azure-dynamics/navigator/fabrication/navigator.csv

Reference | Value | DigiKey_PN | Footprint | Qty
C1 | 100uF | PCE3809CT-ND | Capacitor_SMD:CP_Elec_8x10.5 | 1
C2 | 10uF | 1276-3387-1-ND | Capacitor_SMD:C_1210_3225Metric | 1
C3,C6 | 10uF | 1276-2872-1-ND | Capacitor_SMD:C_0805_2012Metric | 2
C4,C12 | 1uF | 490-1695-1-ND | Capacitor_SMD:C_0805_2012Metric | 2
C5 | 47uF | GRM32ER61C476ME15L | Capacitor_SMD:C_1210_3225Metric | 1
C7,C8,C9,C10,C11,C13 | 0.1uF | 1276-1003-1-ND | Capacitor_SMD:C_0805_2012Metric | 6
D1,D2 | D_Schottky | MBR0560TPMSCT-ND | Diode_SMD:D_SOD-123 | 2
J1,J2,J3,J4,J5,J6 | BLDC-1 | 2057-PH1RB-03-UA-ND | Connector_PinHeader_2.54mm:PinHeader_1x03_P2.54mm_Horizontal | 6
J7 | Conn_01x02_Pin | 455-S2P-VH-ND | Connector_JST:JST_VH_S2P-VH_1x02_P3.96mm_Horizontal | 1
J8 | USB_C_Receptacle_USB2.0_16P | 664-12401948E412ACT-ND | Connector_USB:USB_C_Receptacle_Amphenol_12401948E412A | 1
J9 | Conn_01x04_Pin | 455-1566-1-ND | Connector_JST:JST_GH_BM04B-GHS-TBT_1x04-1MP_P1.25mm_Vertical | 1
J10 | GPIO | 1528-2831-ND | Connector_PinSocket_2.54mm:PinSocket_2x20_P2.54mm_Vertical | 1
R1,R2,R3,R4,R5,R6,R9,R14,R15,R16,R17 | 10k | RMCF0805JT10K0CT-ND | Resistor_SMD:R_0805_2012Metric | 11
R7 | 100k | 311-100KARCT-ND | Resistor_SMD:R_0805_2012Metric | 1
R8 | 14k3 | 118-CR0805-FX-1432ELFCT-ND | Resistor_SMD:R_0805_2012Metric | 1
R10,R11 | 5k1 | RMCF0805JT5K10CT-ND | Resistor_SMD:R_0805_2012Metric | 2
R12,R13 | 2k2 | A106060CT-ND | Resistor_SMD:R_0805_2012Metric | 2
SW1,SW2 | SW_SPST | EG5350CT-ND | Button_Switch_SMD:SW_SPST_TL3305A | 2
U1 | AP2112K-3.3 | AP2112K-3.3TRG1DICT-ND | Package_TO_SOT_SMD:SOT-23-5 | 1
U2 | MPM3550EGLE | 1589-2043-ND | Package_LGA:MPS_LGA-18-10EP_12x12mm_P3.3mm | 1
U3 | BNO086 | 1888-BNO086CT-ND | BNO086:BNO086 | 1
U4 | ESP32-S3-MINI-1U | 1965-ESP32-S3-MINI-1U-N8CT-ND | PCM_Espressif:ESP32-S3-MINI-1U | 1
U5 | INA226 | 296-29034-1-ND | Package_SO:TSSOP-10_3x3mm_P0.5mm | 1
