azure-dynamics/navigator/hardware/navigator.kicad_pcb

## KiCad design hardware/navigator.kicad_pcb (2026-11-02)

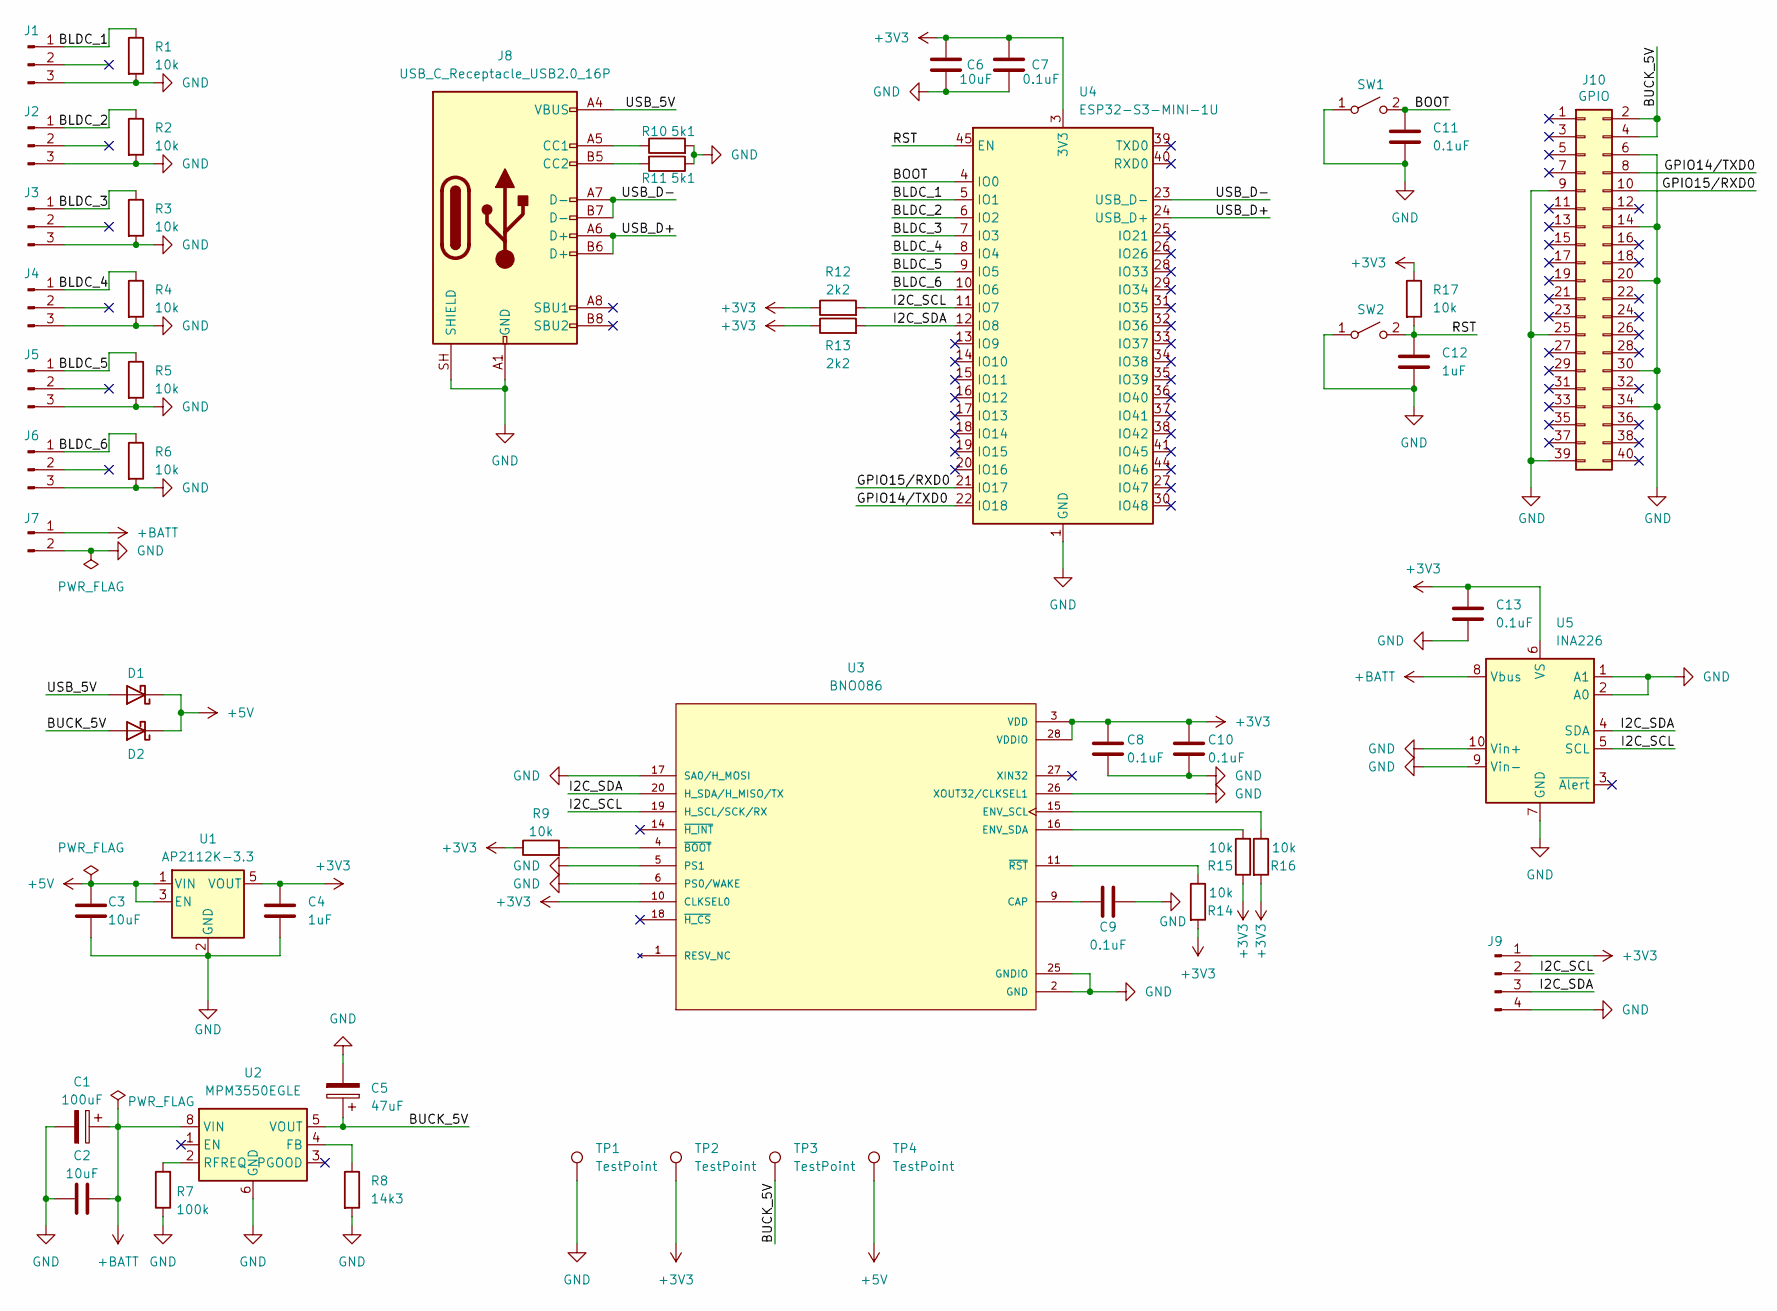
[picture p1: schematic navigator.kicad_sch]

Parts:
C1: 100uF; CP_Elec_8x10.5; DigiKey_PN PCE3809CT-ND
C2: 10uF; C_1210_3225Metric; DigiKey_PN 1276-3387-1-ND
C3, C6: 10uF; C_0805_2012Metric; DigiKey_PN 1276-2872-1-ND
C4, C12: 1uF; C_0805_2012Metric; DigiKey_PN 490-1695-1-ND
C5: 47uF; C_1210_3225Metric; DigiKey_PN GRM32ER61C476ME15L
C7, C8, C9, C10, C11, C13: 0.1uF; C_0805_2012Metric; DigiKey_PN 1276-1003-1-ND
D1, D2: D_Schottky; D_SOD-123; DigiKey_PN MBR0560TPMSCT-ND
J1, J2, J3, J4, J5, J6: BLDC-1; PinHeader_1x03_P2.54mm_Horizontal; DigiKey_PN 2057-PH1RB-03-UA-ND
J7: Conn_01x02_Pin; 282837-2; DigiKey_PN A113320-ND
J8: USB_C_Receptacle_USB2.0_16P; USB_C_Receptacle_Amphenol_12401948E412A; DigiKey_PN 664-12401948E412ACT-ND
J9: Conn_01x04_Pin; JST_GH_BM04B-GHS-TBT_1x04-1MP_P1.25mm_Vertical; DigiKey_PN 455-1566-1-ND
J10: GPIO; PinSocket_2x20_P2.54mm_Vertical; DigiKey_PN 1528-2831-ND
R1, R2, R3, R4, R5, R6, R9, R14, R15, R16, R17: 10k; R_0805_2012Metric; DigiKey_PN RMCF0805JT10K0CT-ND
R7: 100k; R_0805_2012Metric; DigiKey_PN 311-100KARCT-ND
R8: 14k3; R_0805_2012Metric; DigiKey_PN 118-CR0805-FX-1432ELFCT-ND
R10, R11: 5k1; R_0805_2012Metric; DigiKey_PN RMCF0805JT5K10CT-ND
R12, R13: 2k2; R_0805_2012Metric; DigiKey_PN A106060CT-ND
SW1, SW2: SW_SPST; SW_SPST_TL3305A; DigiKey_PN EG5350CT-ND
TP1, TP2, TP3, TP4: TestPoint; TestPoint_Pad_1.5x1.5mm
U1: AP2112K-3.3; SOT-23-5; DigiKey_PN AP2112K-3.3TRG1DICT-ND
U2: MPM3550EGLE; MPS_LGA-18-10EP_12x12mm_P3.3mm; DigiKey_PN 1589-2043-ND
U3: BNO086; PARTREV v1.17; DigiKey_PN 1888-BNO086CT-ND
U4: ESP32-S3-MINI-1U; DigiKey_PN 1965-ESP32-S3-MINI-1U-N8CT-ND
U5: INA226; TSSOP-10_3x3mm_P0.5mm; DigiKey_PN 296-29034-1-ND

Connections:
+3V3: C4.1, C6.1, C7.1, C8.1, C10.1, C13.1, J9.1, R9.1, R12.1, R13.1, R14.2, R15.1, R16.2, R17.1, TP2.1, U1.5 (VOUT), U3.3 (VDD), U3.10 (CLKSEL0), U3.28 (VDDIO), U4.3 (3V3), U5.6 (VS); also elsewhere on the board
+5V: C3.1, D1.1 (K), D2.1 (K), TP4.1, U1.1 (VIN), U1.3 (EN); also elsewhere on the board
+BATT: C1.1, C2.2, J7.1, U2.8 (VIN), U5.8 (Vbus)
/BLDC_1: J1.1, R1.1, U4.5 (IO1)
/BLDC_2: J2.1, R2.1, U4.6 (IO2)
/BLDC_3: J3.1, R3.1, U4.7 (IO3)
/BLDC_4: J4.1, R4.1, U4.8 (IO4)
/BLDC_5: J5.1, R5.1, U4.9 (IO5)
/BLDC_6: J6.1, R6.1, U4.10 (IO6)
/BOOT: C11.1, SW1.2 (B), U4.4 (IO0)
/BUCK_5V: C5.1, D2.2 (A), J10.2, J10.4, TP3.1, U2.5 (VOUT); also elsewhere on the board
/GPIO14/TXD0: J10.8, U4.22 (IO18)
/GPIO15/RXD0: J10.10, U4.21 (IO17)
/I2C_SCL: J9.2, R12.2, U3.19 (H_SCL/SCK/RX), U4.11 (IO7), U5.5 (SCL)
/I2C_SDA: J9.3, R13.2, U3.20 (H_SDA/H_MISO/TX), U4.12 (IO8), U5.4 (SDA)
/RST: C12.1, R17.2, SW2.2 (B), U4.45 (EN)
/USB_5V: D1.2 (A), J8.A4 (VBUS), J8.A9 (VBUS), J8.B4 (VBUS), J8.B9 (VBUS)
/USB_D+: J8.A6 (D+), J8.B6 (D+), U4.24 (USB_D+)
/USB_D-: J8.A7 (D-), J8.B7 (D-), U4.23 (USB_D-)
GND: C1.2, C2.1, C3.2, C4.2, C5.2, C6.2, C7.2, C8.2, C9.2, C10.2, C11.2, C12.2, C13.2, J1.3, J2.3, J3.3, J4.3, J5.3, J6.3, J7.2, J8.A1 (GND), J8.A12 (GND), J8.B1 (GND), J8.B12 (GND), J8.SH (SHIELD), J9.4, J10.6, J10.9, J10.14, J10.20, J10.25, J10.30, J10.34, J10.39, R1.2, R2.2, R3.2, R4.2, R5.2, R6.2, R7.1, R8.2, R10.2, R11.1, SW1.1 (A), SW2.1 (A), TP1.1, U1.2 (GND), U2.6 (GND), U2.7 (GND), U2.9 (GND), U2.10 (GND), U2.11 (GND), U2.12 (GND), U2.13 (GND), U2.14 (GND), U2.15 (GND), U2.16 (GND), U2.17 (GND), U2.18 (GND), U3.2 (GND), U3.5 (PS1), U3.6 (PS0/WAKE), U3.17 (SA0/H_MOSI), U3.25 (GNDIO), U3.26 (XOUT32/CLKSEL1), U4.1 (GND), U4.2 (GND), U4.42 (GND), U4.43 (GND), U4.46 (GND), U4.47 (GND), U4.48 (GND), U4.49 (GND), U4.50 (GND), U4.51 (GND), U4.52 (GND), U4.53 (GND), U4.54 (GND), U4.55 (GND), U4.56 (GND), U4.57 (GND), U4.58 (GND), U4.59 (GND), U4.60 (GND), U4.61 (GND), U4.62 (GND), U4.63 (GND), U4.64 (GND), U4.65 (GND), U5.1 (A1), U5.2 (A0), U5.7 (GND), U5.9 (Vin-), U5.10 (Vin+); also elsewhere on the board
unnamed: J8.A5 (CC1), R10.1
unnamed: J8.B5 (CC2), R11.2
unnamed: R8.1, U2.4 (FB)
unnamed: R7.2, U2.2 (RFREQ)
unnamed: C9.1, U3.9 (CAP)
unnamed: R16.1, U3.15 (ENV_SCL)
unnamed: R15.2, U3.16 (ENV_SDA)
unnamed: R9.2, U3.4 (~BOOT)
unnamed: R14.1, U3.11 (~RST)

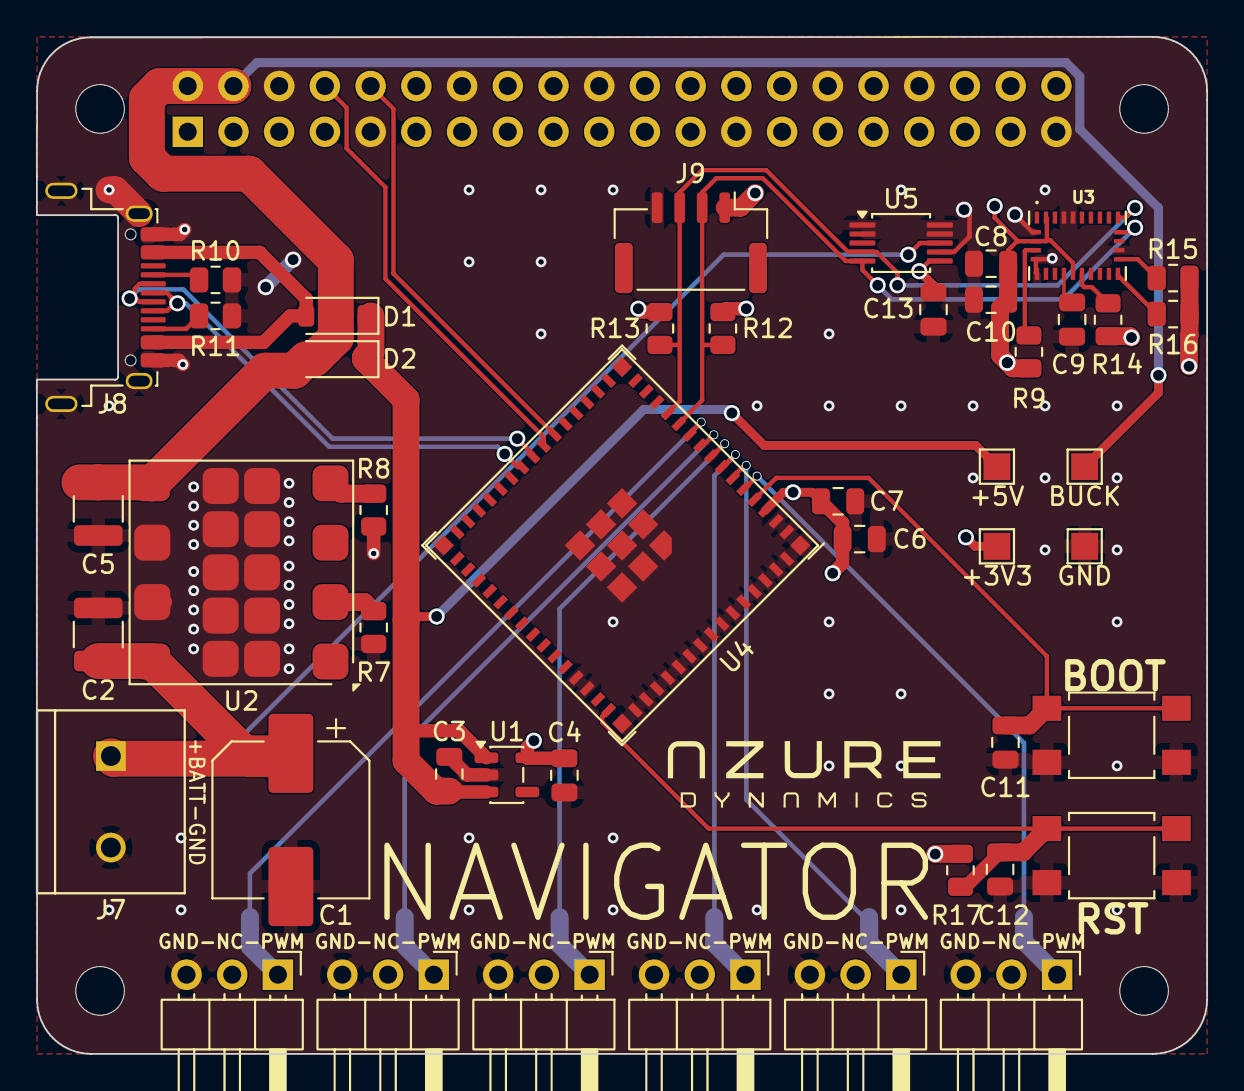
[picture p2: board navigator.kicad_pcb from above]

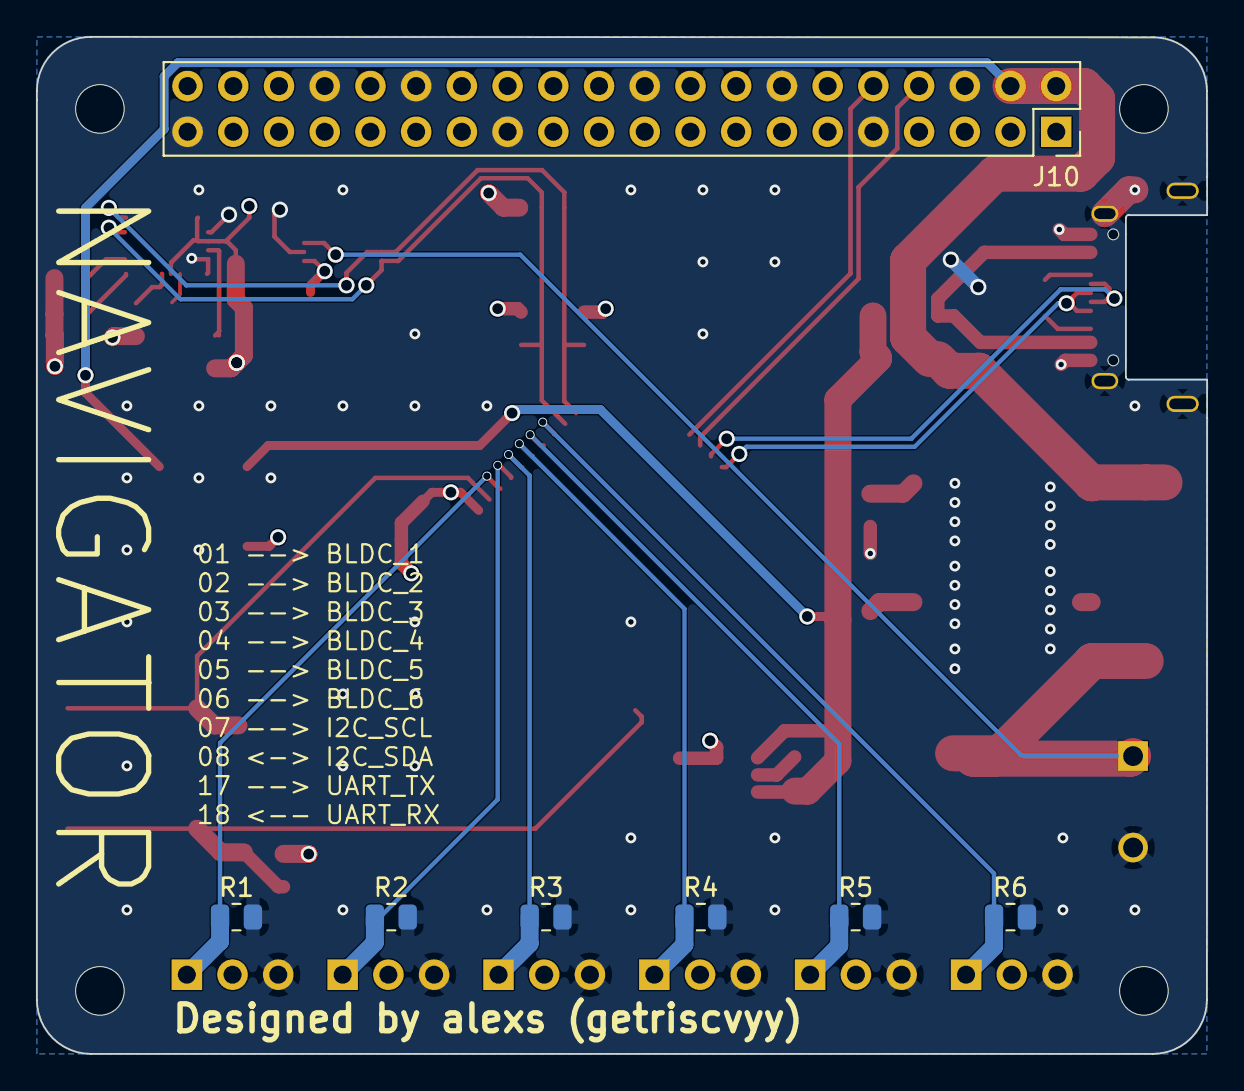
[picture p3: board navigator.kicad_pcb from below]

Board: 4 copper layers, 65.0 x 56.5 mm, 57 parts (7 on the bottom side), 29 nets.

Other parts of the board:
+3V3, +5V: TestPoint; TestPoint_Pad_1.5x1.5mm
BUCK: TestPoint; TestPoint_Pad_1.5x1.5mm
GND: TestPoint; TestPoint_Pad_1.5x1.5mm
MH1, MH2, MH3, MH4: MountingHole_2.7mm_M2.5

Their connections:
+3V3: +3V3.1 (1_1); also elsewhere on the board
+5V: +5V.1 (1_1); also elsewhere on the board
/BUCK_5V: BUCK.1 (1_1); also elsewhere on the board
GND: GND.1 (1_1); also elsewhere on the board
