azure-dynamics/navigator/(commit log)

2026-10-31 chore: add gitignore for kicad local files
2026-10-31 feat: update navigator hardware to revision 002
    [navigator.kicad_pcb, navigator.kicad_sch]
2026-10-31 chore: update fabrication bom for revision 002
    [navigator.csv]
2026-11-01 fix: clean up pcb silkscreen and designators
    [navigator.kicad_pcb]
2026-11-02 feat: add test points
    [navigator.kicad_pcb, navigator.kicad_sch]
2026-11-03 fix: update BoM values
    [navigator.kicad_sch]
